Schenktronics/ST03-attenuverter/hardware/attenuverter/attenuverter BOM.xlsx

Manufacturer Part Number | Manufacturer | Customer Reference | Reference Designator | Quantity | Description
CC0805JRNPO9BN100 | Yageo |  | C1, C2, C3, C7 | 4 | CAP CER 10PF 50V C0G/NPO 0805
08053C104KAT2A | AVX Corporation |  | C4, C6, C9 | 3 | CAP CER 0.1UF 25V X7R 0805
TMK212BBJ106KG-T | Taiyo Yuden |  | C5, C8 | 2 | CAP CER 10UF 25V X5R 0805
MRA4003T3G | ON Semiconductor |  | D1, D2 | 2 | DIODE GEN PURP 300V 1A SMA
0ZCJ0020FF2E | Bel Fuse Inc. |  | F1, F2 | 2 | PTC RESET FUSE 30V 200MA 1206
MJ-3507 | CUI Devices |  | J1, J2, J3, J4, J5, J6, J8, J9 | 8 | CONN AUDIO JACK 3.5MM MONO
302-S101 | On Shore Technology Inc. |  | J7 | 1 | CONN HEADER VERT 10POS 2.54MM
LM4040DYM3-5.0-TR | Microchip Technology |  | U2 | 1 | IC VREF SHUNT 1% SOT23-3
RC0805FR-07100KL | Yageo |  | R1, R2, R4, R5, R6, R7, R9, R10, R12, R13, R15, R16, R17, R18, R20, R21 | 16 | RES SMD 100K OHM 1% 1/8W 0805
RC0805FR-07100RL | Yageo |  | R3, R8, R14, R19 | 4 | RES SMD 100 OHM 1% 1/8W 0805
RC0805FR-071KL | Yageo |  | R11 | 1 | RES SMD 1K OHM 1% 1/8W 0805
TL074CDR | Texas Instruments |  | U1 | 1 | IC OPAMP JFET 4 CIRCUIT 14SOIC
PTV09A-4225F-B104 | Bourns Inc. |  | RV1, RV2, RV3, RV4 | 4 | POT 100K OHM 1/20W CARBON LINEAR
1221-J | Davies Molding, LLC | Knobs |  | 4 | KNOB SERRATED 0.236" PLASTIC
