Schenktronics/ST03-attenuverter/hardware/attenuverter/Attenuverter.step

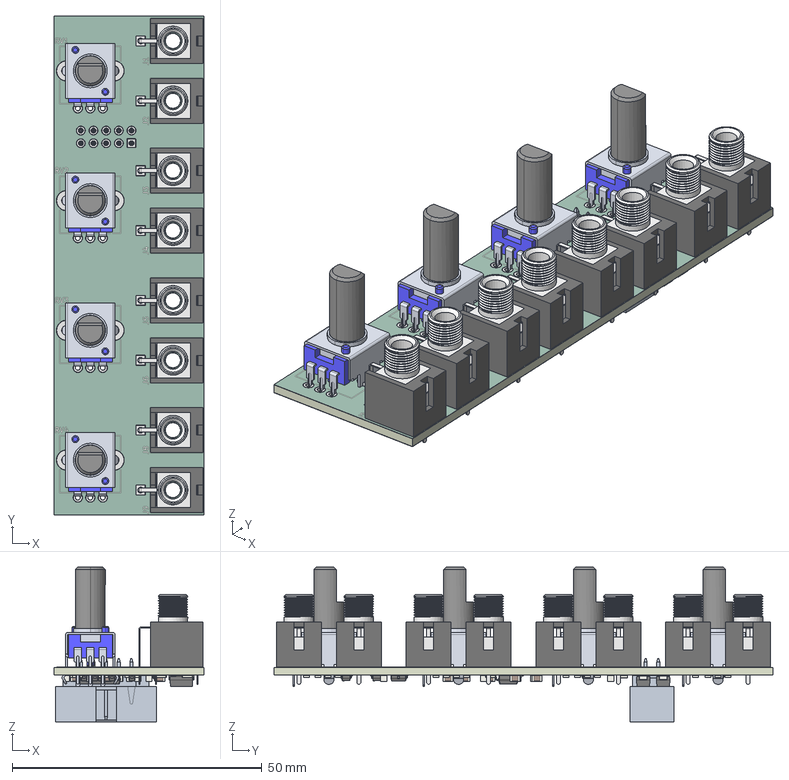
[picture p1: CAD file, 2026-11-01]
hardware/attenuverter/Attenuverter.step
30.0 x 100.0 x 31.0 mm
Thonkiconn - PJ398SM v10 x 8
PTV09A-4X20F-XXXCX_2 x 4
PTV09A-4X20F-XXXCX x 4
C_0805_2012Metric x 13
D_SMA x 2
SOT-23
R_0805_2012Metric x 29
Fuse_1206_3216Metric x 2
SOIC-14_3.9x8.7mm_P1.27mm
D_SOD-323 x 9
Attenuverter_copper
Attenuverter_pad
Attenuverter_via
Attenuverter_silkscreen x 2
Attenuverter_soldermask x 2
Attenuverter_PCB
