Schenktronics/ST03-attenuverter/hardware/panel/AttenuverterFaceplate.step

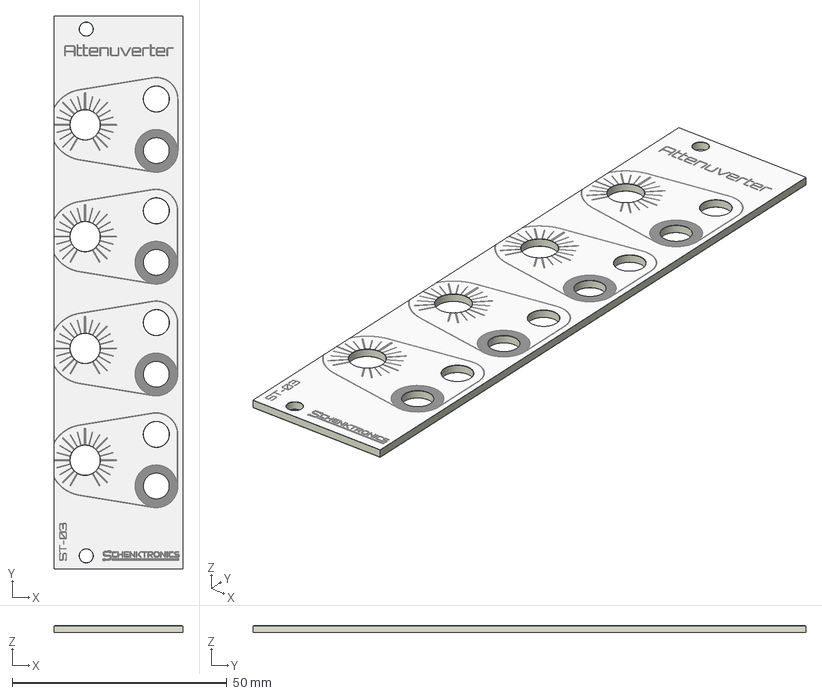
[picture p2: CAD file, 2026-11-01]
hardware/panel/AttenuverterFaceplate.step
30.0 x 128.5 x 1.64 mm
AttenuverterFaceplate_copper
AttenuverterFaceplate_silkscreen
AttenuverterFaceplate_soldermask x 2
AttenuverterFaceplate_PCB
