Schenktronics/ST03-attenuverter/hardware/ST-03_Attenuverter.step

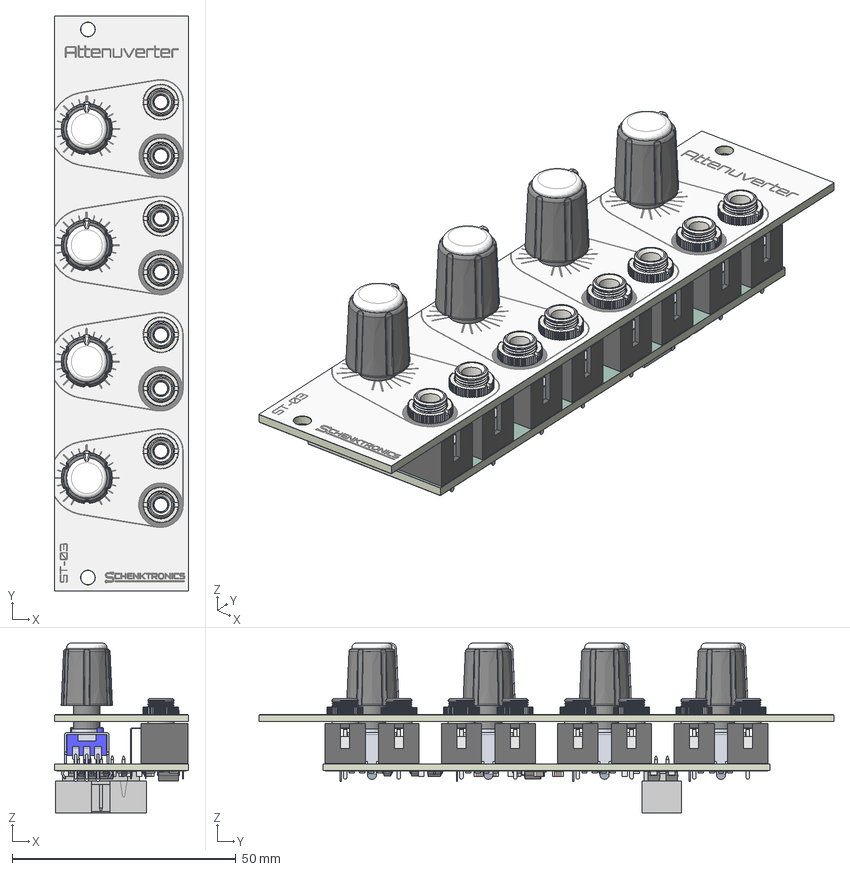
[picture p3: CAD file, 2026-11-01]
hardware/ST-03_Attenuverter.step
30.0 x 128.5 x 38.0 mm
Thonkiconn - PJ398SM v10 x 8
PTV09A-4X20F-XXXCX_2 x 4
PTV09A-4X20F-XXXCX x 4
C_0805_2012Metric_1 x 13
D_SMA_1 x 2
SOT-23_1
R_0805_2012Metric_1 x 29
Fuse_1206_3216Metric_1 x 2
SOIC-14_3.9x8.7mm_P1.27mm_1
D_SOD-323_1 x 9
Attenuverter_copper
Attenuverter_pad
Attenuverter_via
Attenuverter_silkscreen
Attenuverter_silkscreen_1
Attenuverter_soldermask
Attenuverter_soldermask_1
Attenuverter_PCB
AttenuverterFaceplate_copper
AttenuverterFaceplate_silkscreen
AttenuverterFaceplate_soldermask
AttenuverterFaceplate_soldermask_1
AttenuverterFaceplate_PCB
1221-J x 4
