Schenktronics/ST03-attenuverter/manufacturing/panel/AttenuverterFaceplate Drawing v1 Sheet1.dxf

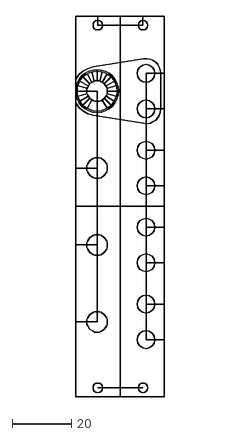
[picture p4: CAD file, 2026-10-08]
manufacturing/panel/AttenuverterFaceplate Drawing v1 Sheet1.dxf
30.0 x 128.5
