Schenktronics/ST03-attenuverter/hardware/attenuverter/Attenuverter.kicad_pcb

## KiCad design hardware/attenuverter/Attenuverter.kicad_pcb (2026-10-26)

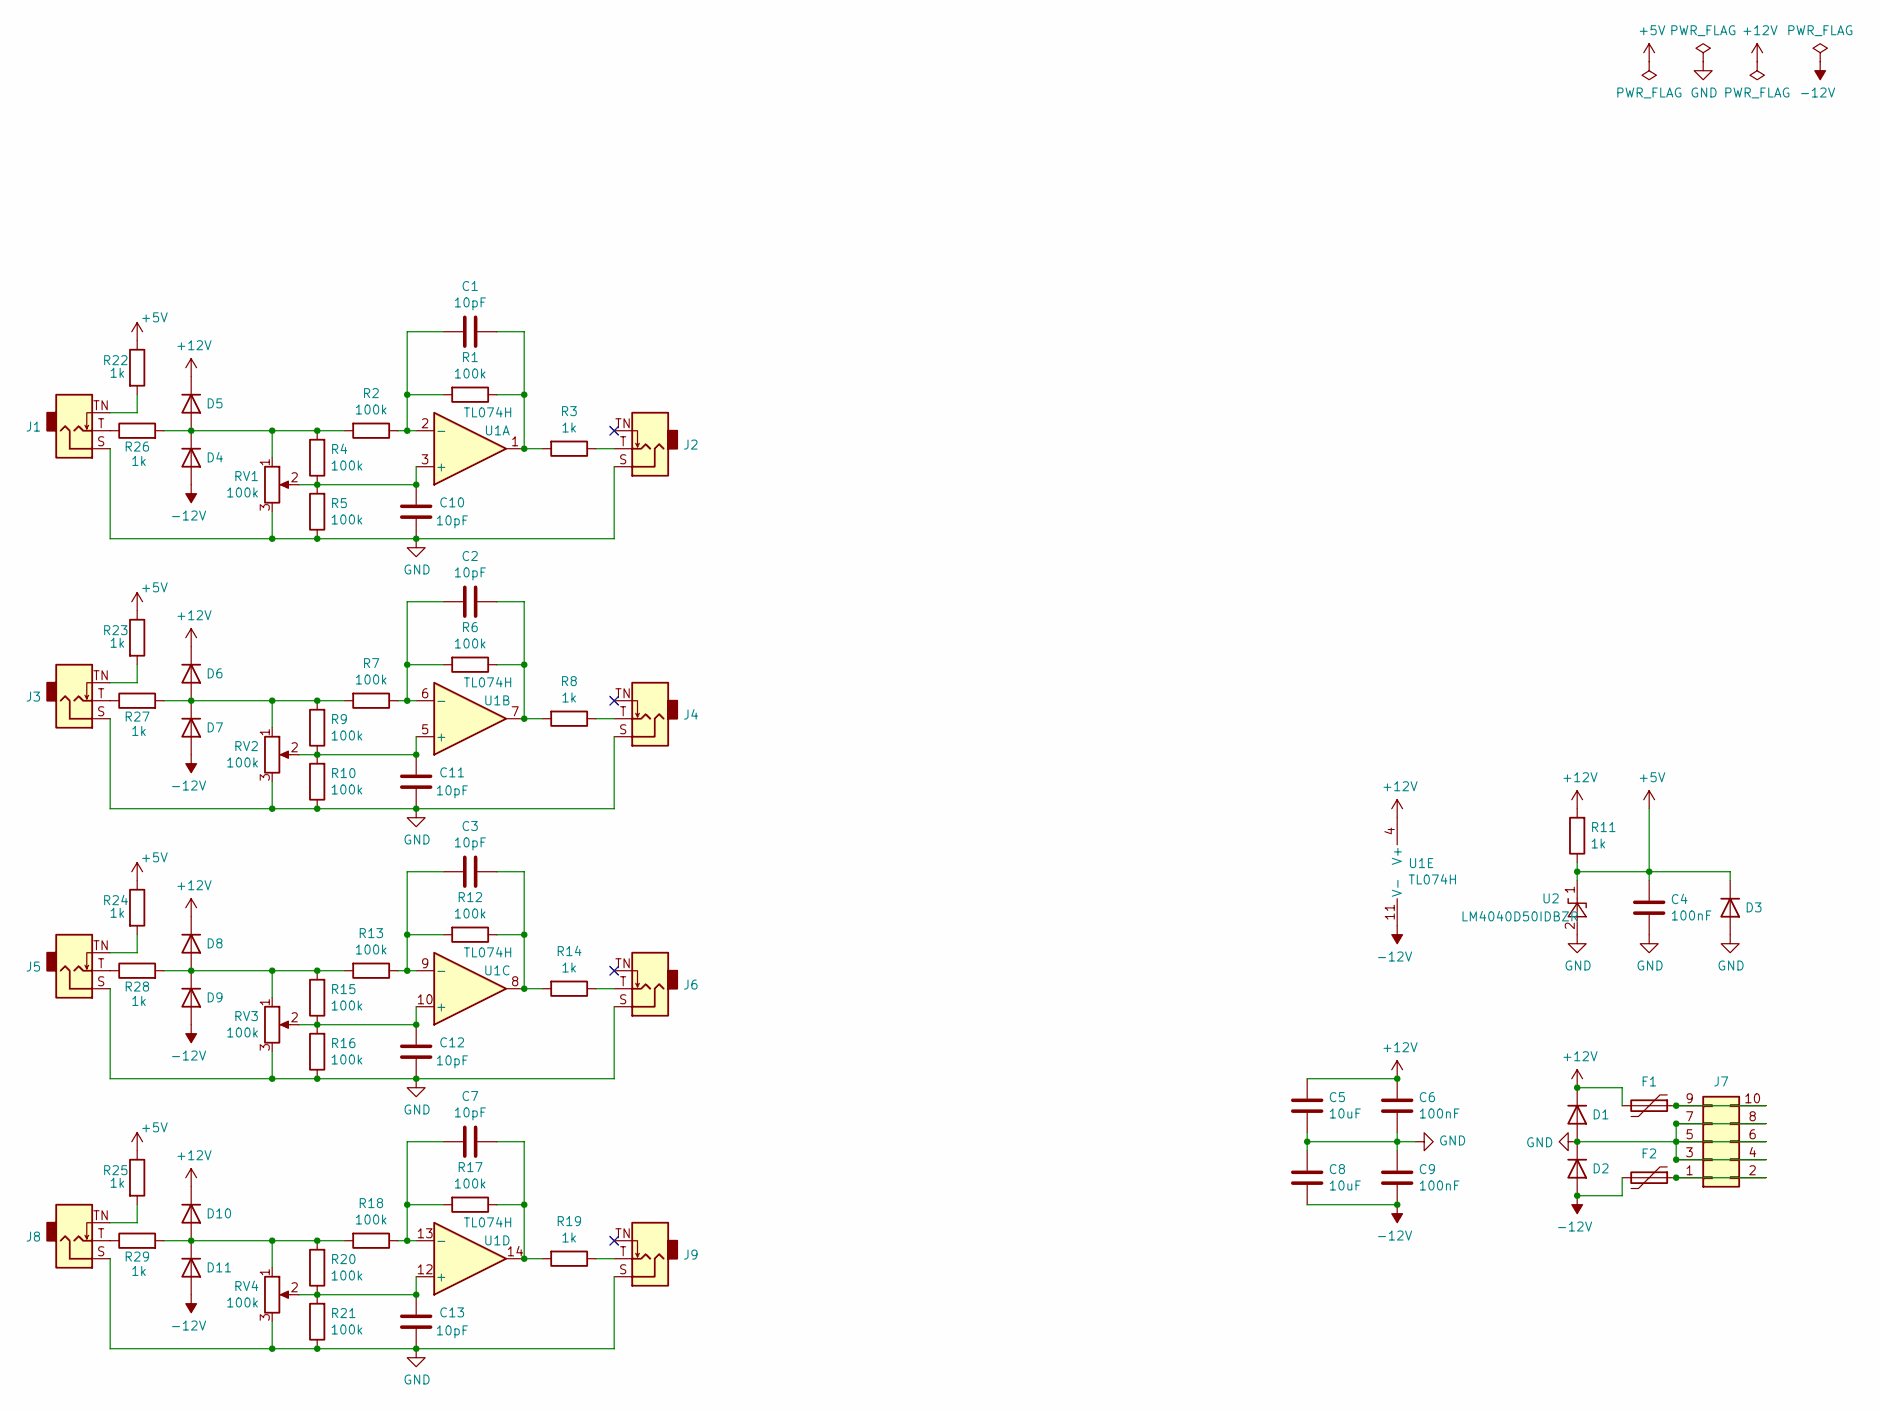
[picture p15: schematic Attenuverter.kicad_sch]

Parts:
C1, C2, C3, C7, C10, C11, C12, C13: 10pF; C_0805_2012Metric
C4, C6, C9: 100nF; C_0805_2012Metric
C5, C8: 10uF; C_0805_2012Metric
D1, D2: D; D_SMA
D3, D4, D5, D6, D7, D8, D9, D10, D11: 1N4148WS-7-F; D_SOD-323
F1, F2: Polyfuse; Fuse_1206_3216Metric
J1, J2, J3, J4, J5, J6, J8, J9: AudioJack2_SwitchT; Jack_3.5mm_QingPu_WQP-PJ398SM_Vertical_CenterHole_OvalPads
J7: Conn_02x05_Odd_Even; PinHeader_2x05_P2.54mm_Vertical_Shrouded
R1, R2, R4, R5, R6, R7, R9, R10, R12, R13, R15, R16, R17, R18, R20, R21: 100k; R_0805_2012Metric
R3, R8, R11, R14, R19, R22, R23, R24, R25, R26, R27, R28, R29: 1k; R_0805_2012Metric
RV1, RV2, RV3, RV4: 100k; Potentiometer_Alps_RK09L_Plated_Mount_Holes
U1: TL074H; SOIC-14_3.9x8.7mm_P1.27mm
U2: LM4040D50IDBZR; SOT-23

Connections:
+5V: C4.1, D3.1 (K), R11.1, R22.1, R23.1, R24.1, R25.1, U2.1 (K)
+12V: C5.1, C6.1, D1.1 (K), D5.1 (K), D6.1 (K), D8.1 (K), D10.1 (K), F1.2, R11.2, U1.4 (V+)
-12V: C8.2, C9.2, D2.2 (A), D4.2 (A), D7.2 (A), D9.2 (A), D11.2 (A), F2.2, U1.11 (V-)
GND: C4.2, C5.2, C6.2, C8.1, C9.1, C10.2, C11.2, C12.2, C13.2, D1.2 (A), D2.1 (K), D3.2 (A), J1.S, J2.S, J3.S, J4.S, J5.S, J6.S, J7.3, J7.4, J7.5, J7.6, J7.7, J7.8, J8.S, J9.S, R5.1, R10.1, R16.1, R21.1, RV1.3, RV2.3, RV3.3, RV4.3, U2.2 (A)
unnamed: C1.1, R1.1, R3.2, U1.1
unnamed: C2.1, R6.1, R8.2, U1.7
unnamed: C3.1, R12.1, R14.2, U1.8
unnamed: C7.1, R17.1, R19.2, U1.14
unnamed: D4.1 (K), D5.2 (A), R2.2, R4.2, R26.2, RV1.1
unnamed: D6.2 (A), D7.1 (K), R7.2, R9.2, R27.2, RV2.1
unnamed: D8.2 (A), D9.1 (K), R13.2, R15.2, R28.2, RV3.1
unnamed: D10.2 (A), D11.1 (K), R18.2, R20.2, R29.2, RV4.1
unnamed: J1.T, R26.1
unnamed: J1.TN, R22.2
unnamed: J2.T, R3.1
unnamed: J3.T, R27.1
unnamed: J3.TN, R23.2
unnamed: J4.T, R8.1
unnamed: J5.T, R28.1
unnamed: J5.TN, R24.2
unnamed: J6.T, R14.1
unnamed: F2.1, J7.1, J7.2
unnamed: F1.1, J7.9, J7.10
unnamed: J8.T, R29.1
unnamed: J8.TN, R25.2
unnamed: J9.T, R19.1
unnamed: C10.1, R4.1, R5.2, RV1.2, U1.3 (+)
unnamed: C1.2, R1.2, R2.1, U1.2 (-)
unnamed: C11.1, R9.1, R10.2, RV2.2, U1.5 (+)
unnamed: C2.2, R6.2, R7.1, U1.6 (-)
unnamed: C12.1, R15.1, R16.2, RV3.2, U1.10 (+)
unnamed: C3.2, R12.2, R13.1, U1.9 (-)
unnamed: C13.1, R20.1, R21.2, RV4.2, U1.12 (+)
unnamed: C7.2, R17.2, R18.1, U1.13 (-)

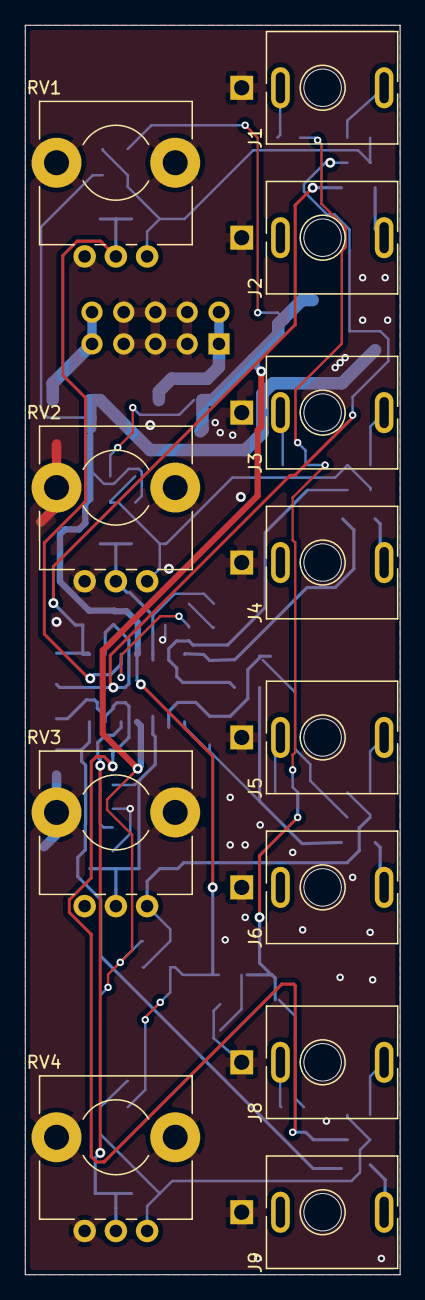
[picture p16: board Attenuverter.kicad_pcb from above]

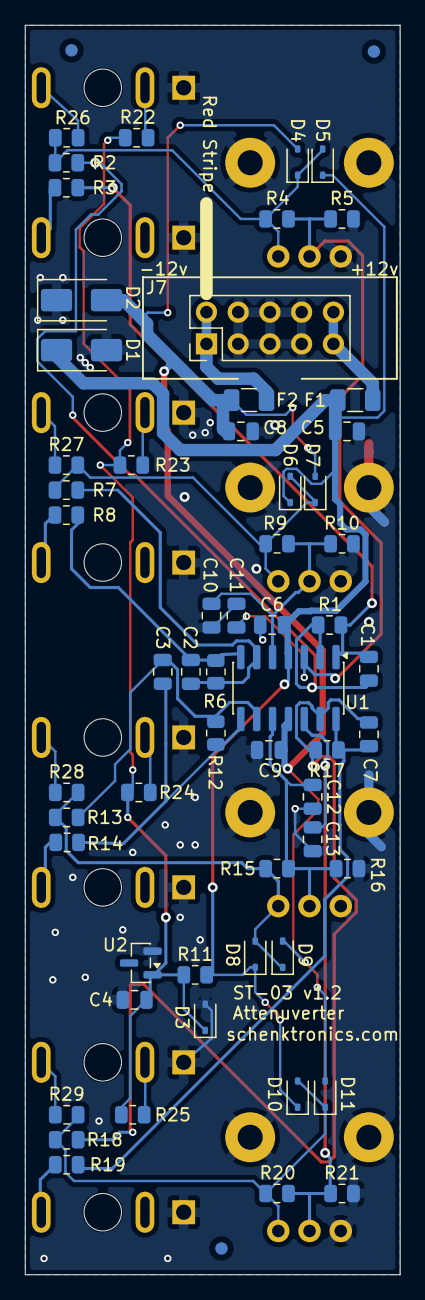
[picture p17: board Attenuverter.kicad_pcb from below]

Board: 2 copper layers, 30.0 x 100.0 mm, 73 parts (61 on the bottom side), 34 nets.

Other parts of the board:
FID1, FID2, FID3: Fiducial_1mm_Mask2mm
