Schenktronics/ST03-attenuverter/(commit log)

2026-10-03 Document input clamp diodes and 1 kΩ outputs
    - Add D3–D11 (1N4148WS-7-F) to the BOM and the assembly guide
    - Clamp each input to ±12 V through the new diodes; note the 1 kΩ input and output resistors
    - Replace the 100 Ω output resistors with 1 kΩ (R3, R8, R14, R19) and update the BOM
    - Add rail and per-diode diode test steps and troubleshooting for reversed clamps
    - Regenerate the step 1 drawing with cathode pads for D1–D11, and move the drawing
    script to a stdlib S-expression parser for KiCad 10 boards
2026-10-03 PCB: align jacks to faceplate, nudge reference designators, add logo
    - Move J1–J6, J8, J9 0.32 mm in X so the jack centers match the faceplate holes
    (faceplate centered on the board outline)
    - Align reference designators to their neighbours (under 1 mm moves)
    - Add the Schenktronics logo to the board
    - Reroute the traces around the moved jacks
2026-10-03 Switch U1 to TL074, regenerate gerbers, and source U1/U2 from TI
    - Change U1 from TL084 to TL074 in the schematic and PCB (same pinout)
    - Source U1 (TL074CDR) and U2 (LM4040DBZ-5) from TI only, per the critical-IC rule
    - Regenerate gerbers and drill files from the current board
2026-10-03 Add SMD pick-and-place file for PCBWay
    - 53 bottom-side SMD parts, positions in the same frame as the gerbers
    - Rotations normalised to 0–359°; through-hole and mechanical parts excluded
2026-10-03 Add bottom-side fiducials and regenerate gerbers
    - Add three 1 mm fiducials (2 mm mask opening) on the bottom side, clear of the jacks
    - Move the logo off the fiducial area
    - Regenerate gerbers, drill files and the zip, including the SMD pick-and-place file
2026-10-03 Use LM4040DIM3X-5.0/NOPB for U2
    - Set the U2 value on the schematic and PCB to LM4040DIM3X-5.0/NOPB
    - Update the BOM to match, and regenerate gerbers, drill files, zip and the SMD CPL
2026-10-04 Update PCB version label to v1.1
2026-10-04 Label input clamp diodes as 1N4148WS-7-F
2026-10-07 Faceplate: squeezed wordmark footer, Orbitron text
    Replaces the lower-left S-mark with the new 2mm-squeezed full wordmark
    (_NTSFootprints:SchentronicsLogoSqueeze2mm), centered in the gap right
    of the bottom screw hole (0.80mm margin each side). Adds ST-03, vertical,
    centered in the left gap, anchored to the wordmark's bottom. Header and
    part number switched from KiCad's italic stroke font to upright Orbitron.
    Note: this file carries other pending local changes from before this
    edit (titleblock/zone data), not just the faceplate update above.
2026-10-07 Faceplate: align mounting-hole X-offset to 7.5mm, re-anchor wordmark/ST-03
    Both rack-screw holes move from ~7.4986/7.4972mm off the left edge to
    exactly 7.5mm, matching the other three boards. Wordmark and ST-03
    shift by the same ~0.0014mm to stay centered off the new hole position.
2026-10-07 Faceplate: move header to the common 8.25mm top offset
    Brings this board in line with the other three (it had drifted to
    7.85mm). Also fixes a real clearance problem, not just consistency:
    at 7.85mm the header's vertical gap to the top screw head left only
    0.35mm of margin -- Orbitron is wide enough that the text's left edge
    already runs past the hole horizontally, so that vertical gap was the
    only thing protecting it. 8.25mm doubles the margin to 0.75mm.
    Note: docs/images/panel.svg here is generated by a script that still
    expects the pre-KiCad-10 Edge.Cuts/module syntax, so it couldn't be
    regenerated -- flagging as pre-existing, not something this touched.
2026-10-07 Title blocks: logo worksheet, consistent company/rev across PCB and schematic
    Repoint page_layout_descr_file (both pcbnew and schematic) from the old
    Windows path to the real one on this machine, so the Schenktronics
    worksheet -- and its embedded logo -- actually loads.
    Fill out/correct title blocks: company standardized to "Schenktronics"
    (was "Nathan Schenk"), and PCB rev brought up to 1.1 to match both the
    real "v1.1" silkscreen text and the schematic's already-correct 1.1 --
    the PCB title block had been stuck at the old 1.0. Faceplate matched to
    the same 1.1 for consistency within the product.
2026-10-07 Title block: add Dolibarr PCB ref (PCB-ST03-MAIN / PCB-ST03-FACE) as comment 4
2026-10-07 Main PCB: harmonize branding text with the Multiple's pattern
    Reformatted "Attenuverter\nv1.1" to "ST-03 v1.1\nAttenuverter" (code +
    version first, name second), matching the Multiple's layout convention.
    Logo stays as the medium S-mark, already in a clear spot.
    Tried adding the CC BY-NC-SA roundels + text too, matching the Multiple,
    but this board is far more densely routed (active circuit vs. the
    Multiple's passive jacks-only layout) -- verified via kicad-cli renders
    that every candidate spot collided with real pads or traces, so left
    them off rather than force an overlap. Space, not a fixed rule, is
    what decided this per board.
2026-10-08 Regenerate gerbers: new rev, branding, and worksheet logo position
    Main board picks up rev 1.1 (was still 1.0 in the last gerber set) and
    the harmonized ST-03 branding text. Faceplate picks up the squeezed
    wordmark, tick marks, and the 7.5mm hole-offset fix.
    Dropped the stale *-F_SilkS.gbr/*-B_SilkS.gbr files on the faceplate --
    this KiCad version names the silkscreen layer "Silkscreen" not "SilkS",
    so the old short-named files were dead weight alongside the new ones.
    Same for the old NPTH-drl_map.plt (not a format kicad-cli produces;
    replaced by the PDF map). Both zips rebuilt to match.
2026-10-08 Restructure into hardware/ and manufacturing/, matching Quad Mixer's layout
    Attenuverter/ -> hardware/attenuverter/ (source) and manufacturing/attenuverter/
    (gerbers plus the SMD placement CSV, moved out). AttenuverterFaceplate/ ->
    hardware/panel/ and manufacturing/panel/ (gerbers plus the panel .dxf).
    KiCad project filenames are unchanged, only their containing folder moved.
    Updates the drawing scripts' hardcoded paths, README's repository-layout
    diagram, and the manual/BOM links.
    Regenerated docs/images/assembly-*.svg (make_assembly_svgs.py here already
    uses a proper S-expression parser, so it ran cleanly) and picked up a real,
    already-committed PCB revision that had never been regenerate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
2026-10-08 Remove stale KiCad legacy/cache/backup files
    - Attenuverter.sch: the old EESchema format schematic, superseded by
    Attenuverter.kicad_sch (which .kicad_pro's top_level_sheets already
    names as the real schematic, is newer, and embeds all 45 of its own
    symbols -- fully self-contained). Updated the manual's schematic link
    to point at .kicad_sch instead, and dropped the now-inaccurate
    '(KiCad 5)' caption.
    - Attenuverter.pro / AttenuverterFaceplate.pro: legacy project files,
    superseded by the already-tracked .kicad_pro
    - Attenuverter.net: legacy netlist export
    - fp-info-cache (both boards): auto-regenerated footprint cache
    - Attenuverter-cache.lib: now fully redundant now that .kicad_s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
2026-10-09 Generate mechanical outline drawings from the assembly STEP file
    Replaces the product photos in the README, manual and assembly guide
    with real HLR projections of the module straight from the STEP files
    in hardware/: a front view, a side profile, four isometric hero-angle
    candidates, and a bare panel+PCB view for the assembly guide's "before
    you start" shot.
    With 9 jacks on the front panel (more than either the Multiple or
    Levels), the front view hit the same coaxial-barrel degenerate case
    documented in the shared generator, but the existing perspective-
    projection fix handled it cleanly in one pass. The side view segfaulted
    once and succeeded on retry, isolated to that one view by the
    gene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
2026-10-09 Switch to a non-detent pot; fix an obsolete LM4040 part number
    New BOM: Bourns PTV09A-4020F-B104 (bushingless, no center detent),
    replacing PTV09A-4225F-B104. Same mounting style and KiCad footprint as
    before (both are the PTV09 family's bushingless rear-mount variant,
    differing only in shaft length and detent option per Bourns' ordering
    code), so no footprint change is needed — only the BOM, the docs that
    described the detent, and the panel/patch drawing scripts' comments.
    The knob (Davies 1221-J) is unchanged.
    Also fixes U2's part number: the old LM4040DIM3X-5.0/NOPB (TI's legacy
    M3X-suffix ordering format) showed up Obsolete with no price at Mouser.
    TI's current datasheet confirms the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
2026-10-09 Update footprints
2026-10-17 Read the KiCad 10 faceplate and regenerate the ST-03 drawings
    make_panel_svg.py still parsed the KiCad 5 format, so the panel and
    patch drawings had been stale since the faceplate change on 2026-10-08:
    they showed four mounting holes instead of two and the old logo
    position. The panel script now reads the file with an S-expression
    reader, converts KiCad 10's three-point arcs, and draws rotated text.
    The surface-mount assembly drawing is dropped, since kits ship with
    those parts soldered. Labels and titles use keyboard punctuation and
    American spelling ("right x1, top 0, left x-1").
2026-10-17 Polish the ST-03 Attenuverter docs for launch: through-hole build only
    Every board ships with its surface-mount parts soldered by the board
    house and tested, so the assembly guide drops the SMD soldering step,
    its parts list, and the per-diode checks, and covers the 54
    through-hole joints. The power-rail short check stays, since the
    builder solders the header, and surface-mount faults go to the contact
    page. The BOM still lists every part for anyone making their own
    boards.
    Fixes: the panel has two rack screw holes, not four; the back of the
    board is printed "ST-03 v1.1 / Attenuverter", not "Attenuverter v1.0";
    and the link to the old Passive Attenuator repo is gone.
    Titles use "ST-03 Atte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
2026-10-17 Square up the jacks before soldering, snug the nuts last
    Nathan's refined build order: hand-tighten the jack nuts, square up the
    jack bodies with small pliers, center the parts, solder everything, and
    only then snug the nuts down. The faceplate drawing's caption now reads
    "..., solder, then tighten the nuts", and its nut label says
    "hand-tighten first".
2026-10-17 Add solder and lead-handling advice to the assembly guide
    The Tools list asks for 0.8 mm flux-core solder and safety glasses,
    without recommending leaded or lead-free, and the iron line notes that
    lead-free runs a little hotter. "First time soldering?" says 63/37 or
    60/40 leaded solder is easier to learn with and leaves the choice to
    the builder, with handling advice for leaded solder (wash hands, no
    eating, drinking, or smoking while soldering, wipe the work surface,
    keep it away from kids) and a separate note on ventilation and flux
    fumes.
2026-10-17 Explain the oval jack pads with the CUI MJ-3507, drop the Mouser project
    The jack pads are oval so the board also takes panel-mount style jacks.
    The README, the BOM's jack row, and a new "Using panel-mount style
    jacks?" note in the assembly guide now say so with one example, the
    CUI MJ-3507, whose sleeve is a solder lug that needs a short wire to
    the square pad. QingPu stays the main part in the BOM.
    The out-of-date Mouser project link and the BOM's "Ordering the
    parts" section are removed.
2026-10-17 Fix the jack pad orientation in the drawings, drop a stray photo
    The drawing script added the footprint's rotation to each pad's angle,
    but KiCad stores the pad angle with the footprint rotation already
    included, so every oval jack pad was drawn rotated 90 degrees. Checked
    against kicad-cli's render of the board.
    Nathan removed the back-of-board photo from the test step and shortened
    the video note, and the now-unused assembled-back.jpg is deleted.
2026-10-17 Say "inverted", not "upside down"; drop "in turn"
    A polarity flip is described as inverted, and the manual defines it as
    every voltage being negated (+3 V becomes -3 V). The assembly guide's
    tests say "one at a time" instead of "in turn", which isn't how
    Nathan talks. The envelope patch drawing's label now reads "inverted
    envelope".
2026-10-17 Correct the input impedance spec, say it depends on the knob position
    Recalculated from the schematic: 34-53 kOhm, lowest fully
    counterclockwise, where the wiper is at ground. The old 33-52 kOhm left
    out the 1k series resistor, and "depending on the knob" didn't say it
    was the knob's position.
2026-10-26 Hardware v1.2: 10 pF from each op-amp + input to ground
    Adds C10-C13 (10 pF C0G, same part as C1-C3 and C7) from each TL074
    non-inverting input to ground. With the knob near center, the + input sits
    at about 17 kOhm, and the op-amp's input capacitance couples the feedback
    onto it, cutting phase margin to 33-52 degrees. The caps hold it at about
    60 degrees or more across the knob's travel, with the 3 MHz or the
    5.25 MHz (TL074H) die. The added pole is at 955 kHz or above.
    Also renames the fiducials FID1-FID3 and bumps the schematic, PCB title
    blocks and silkscreen to v1.2. Docs stay at v1.1 until v1.2 boards exist.
2026-10-26 Use the TL074H for U1, and bring the BOM up to v1.2
    U1 is now the TL074HIDR (TI's H die) in the schematic, PCB and BOM. It
    needs only about 1.5 V of headroom on its inputs, against 3-4 V for the
    legacy die, swings to within about 0.2 V of the rails, and has no phase
    reversal. On +/-12 V, a -10 V input with a knob near full clockwise was
    past the legacy die's guaranteed input range.
    The BOM is now v1.2: TL074HIDR, C10-C13 added to the 10 pF line, and a note
    that v1.1 boards use the TL074CDR and don't have C10-C13. The manual and
    assembly guide stay at v1.1 until v1.2 boards exist.
2026-11-01 Assembly STEP from Fusion: new 1221-J knobs, current board and faceplate
